virajgupta-pixel/emg-reaction-time-arduino/docs/BioE101_EMG_Reaction_Time_Final_Presentation.pdf

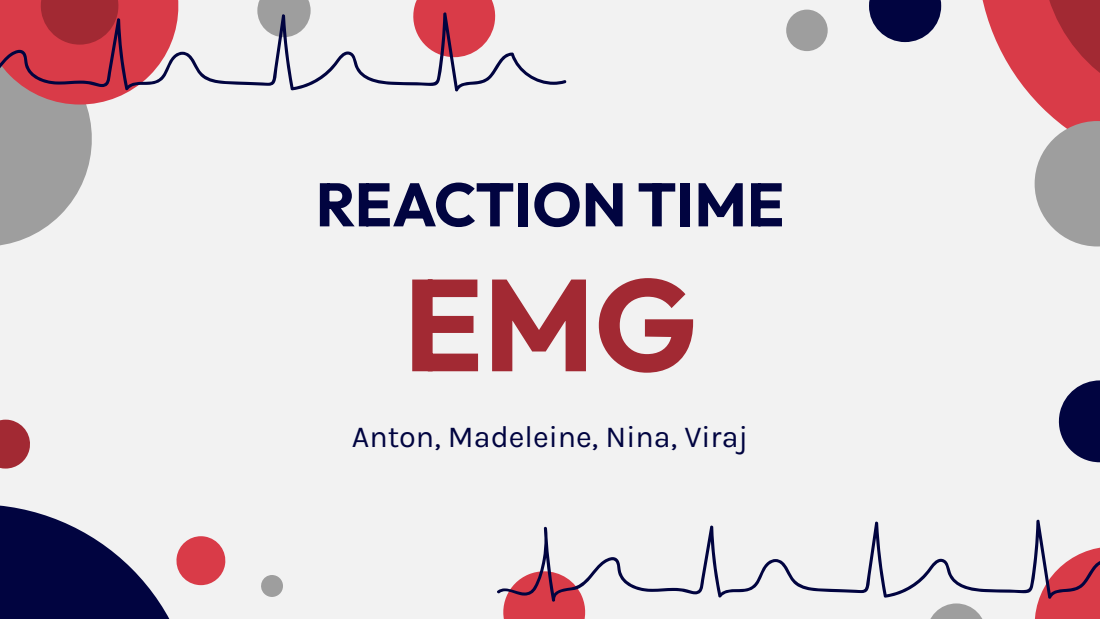
[picture p5: page 1]
REACTION TIME EMG

Anton, Madeleine, Nina, Viraj

10M+

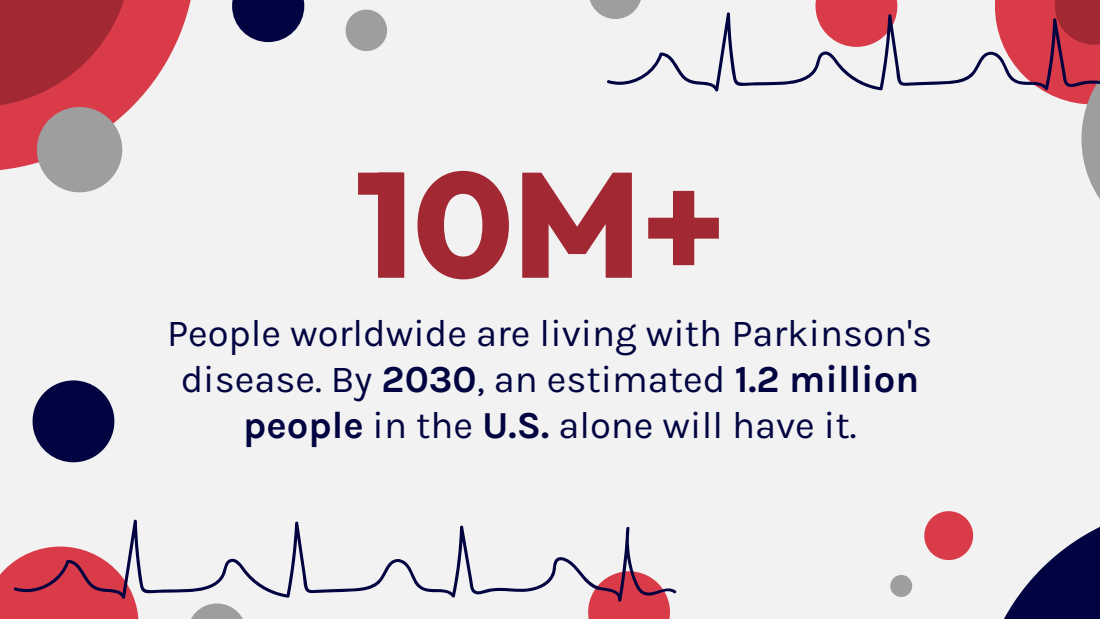
[picture p6: page 2]

People worldwide are living with Parkinson's
disease. By 2030, an estimated 1.2 million
people in the U.S. alone will have it.

# Why Measure Reaction Time?

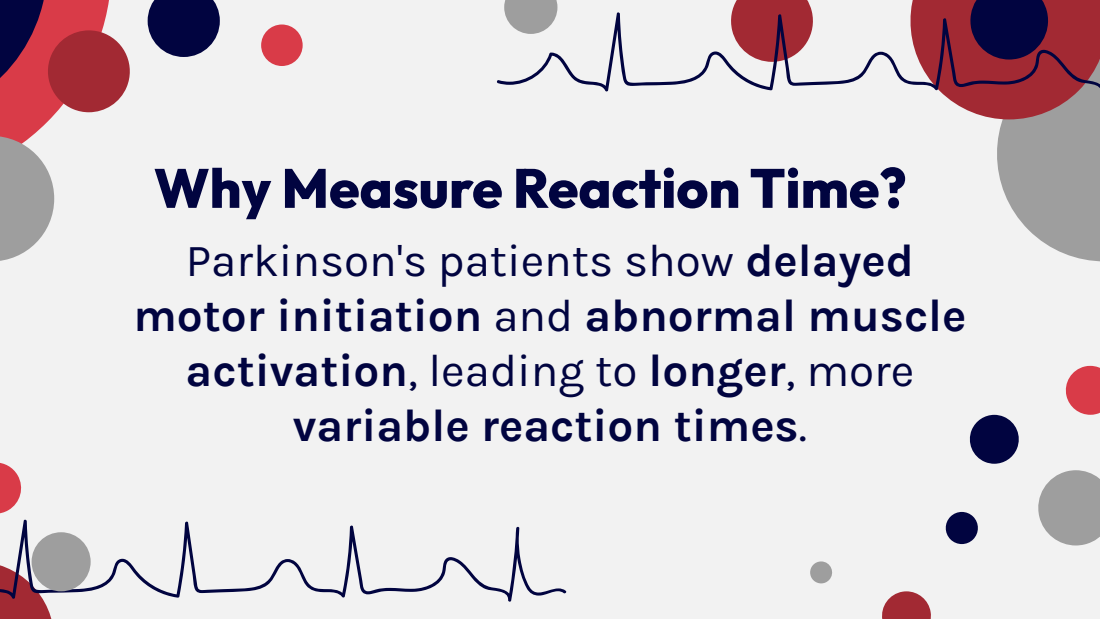
[picture p7: page 3]

Parkinson's patients show delayed
motor initiation and abnormal muscle
activation, leading to longer, more
variable reaction times.

# Compared Reaction Times

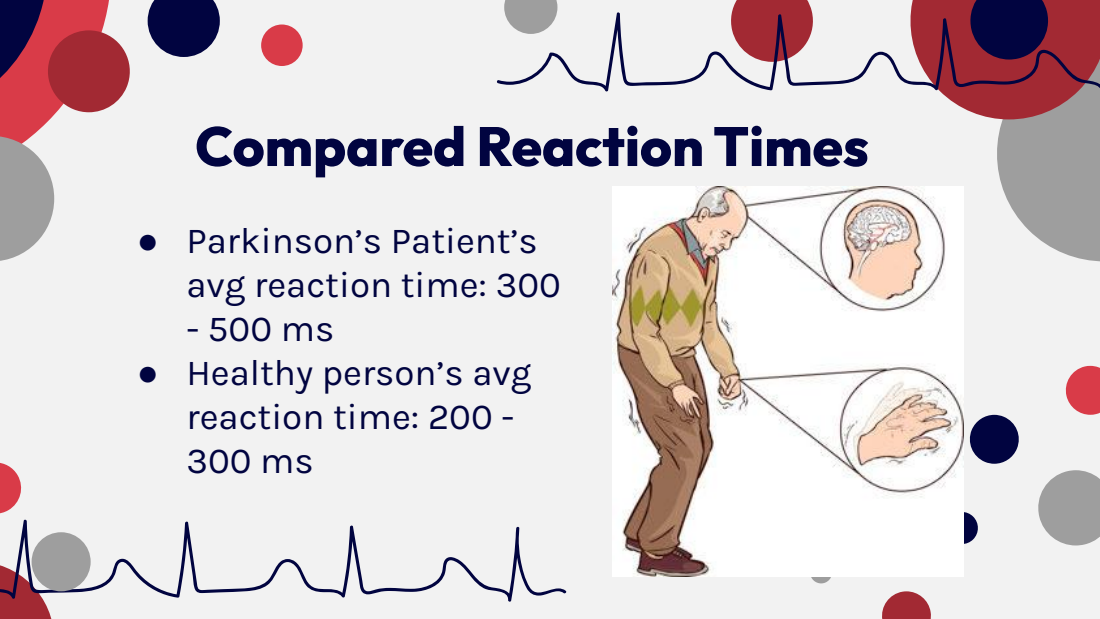
[picture p8: page 4]

● Parkinson’s Patient’s
avg reaction time: 300
● Healthy person’s avg
reaction time: 200 -

# Physiologic Requirements to Engineering Goals

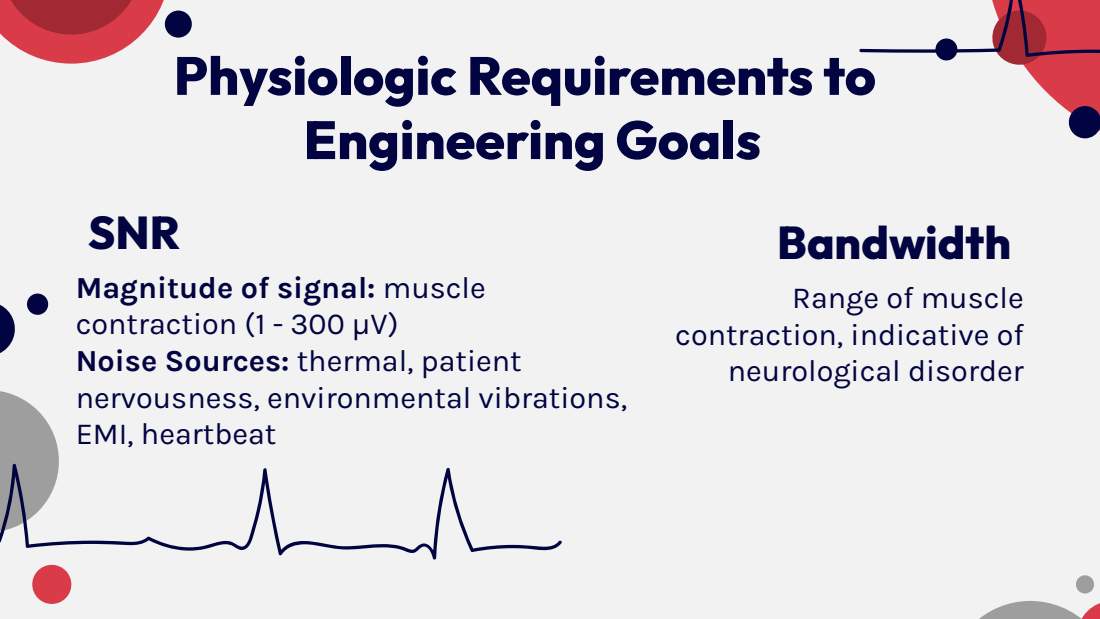
[picture p9: page 5]

SNR
Magnitude of signal: muscle
contraction (1 - 300 µV)
Noise Sources: thermal, patient
nervousness, environmental vibrations,
EMI, heartbeat

Bandwidth
Range of muscle

contraction, indicative of
neurological disorder

# Physiologic Requirements to

Engineering Goals Cont.

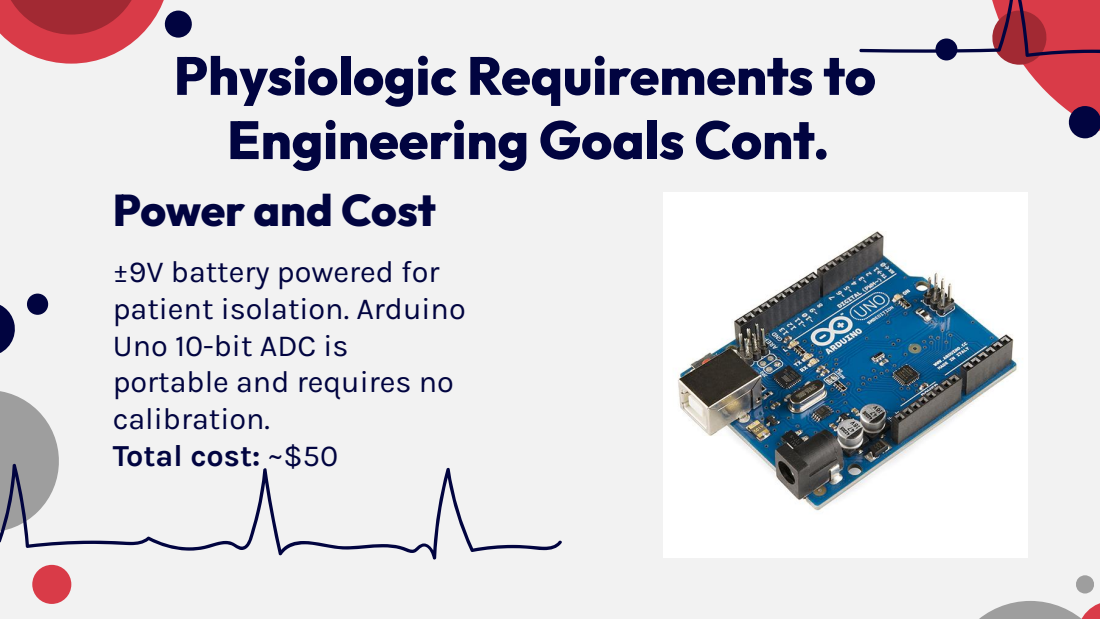
[picture p10: page 6]

Power and Cost

±9V battery powered for
patient isolation. Arduino
Uno 10-bit ADC is
portable and requires no
calibration.
Total cost: ~$50

## Measuring Reaction Time w/ EMGs

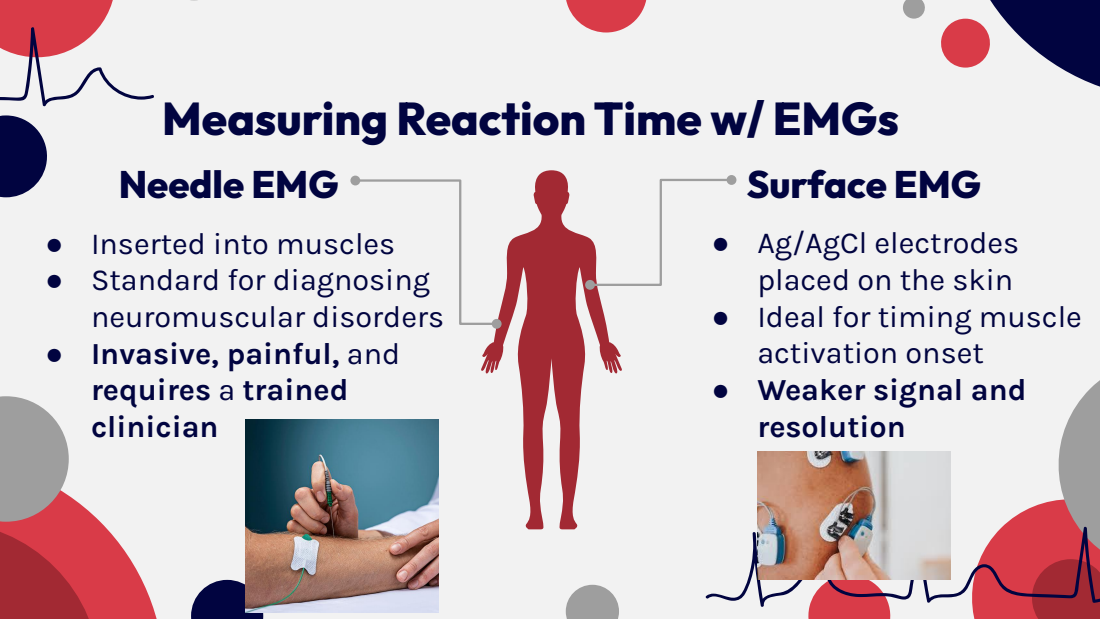
[picture p11: page 7]

Needle EMG
● Inserted into muscles
● Standard for diagnosing
neuromuscular disorders
● Invasive, painful, and
requires a trained
clinician

Surface EMG
● Ag/AgCl electrodes
placed on the skin
● Ideal for timing muscle
activation onset
● Weaker signal and
resolution

## EMG Circuit

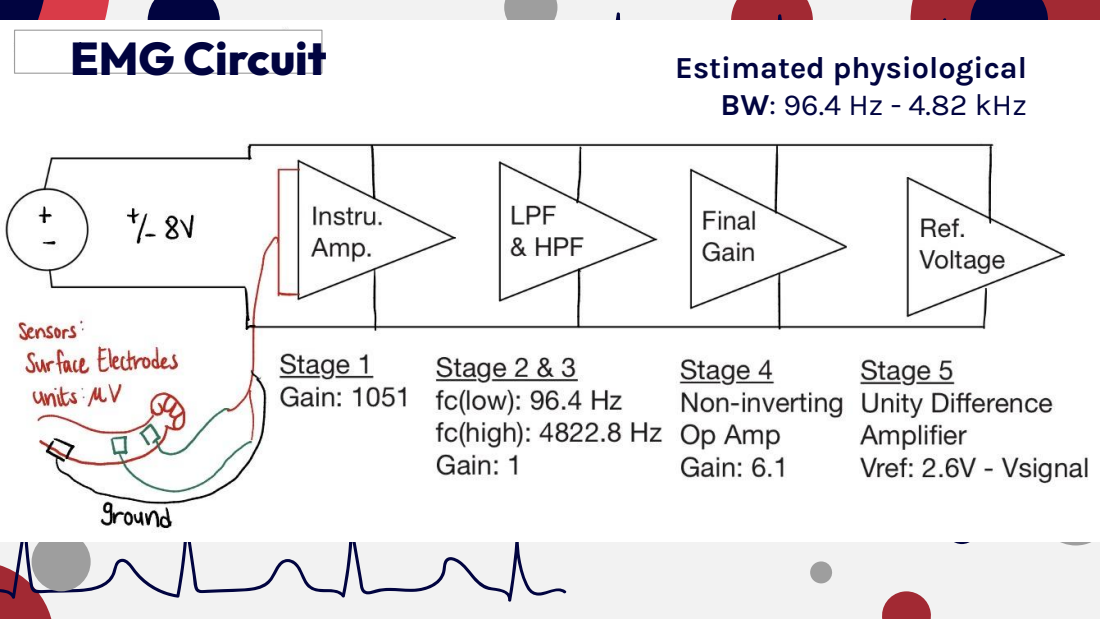
[picture p12: page 8]

Estimated physiological
BW: 96.4 Hz - 4.82 kHz

## Data Flow Circuit

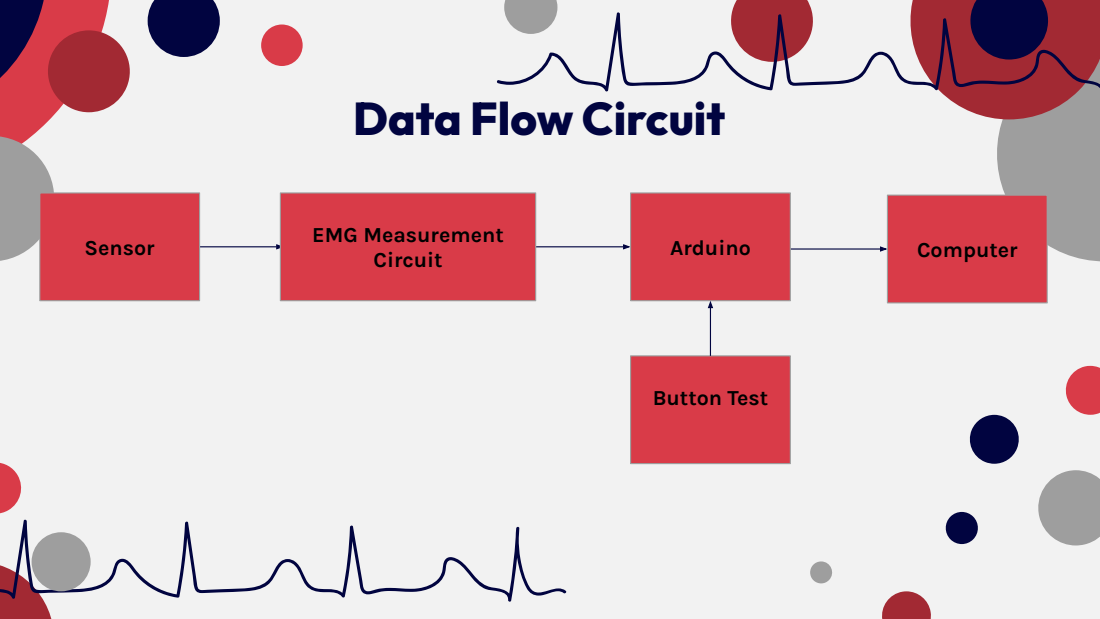
[picture p13: page 9]
Computer; EMG Measurement; Circuit; Arduino; Button Test; Sensor

# Signal, Noise & Interference Model

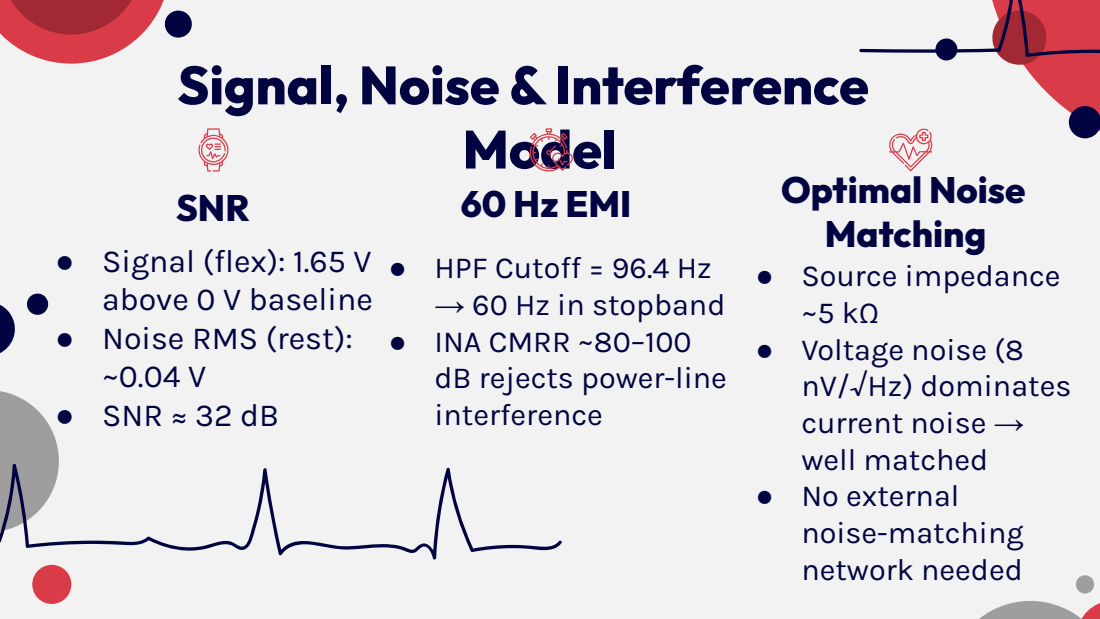
[picture p14: page 10]
60 Hz EMI; SNR

Optimal Noise
Matching
● Source impedance
● Voltage noise (8
nV/√Hz) dominates
current noise →
well matched
● No external
noise-matching
network needed

● Signal (flex): 1.65 V
above 0 V baseline
● Noise RMS (rest):
● SNR ≈ 32 dB

● HPF Cutoff = 96.4 Hz
→ 60 Hz in stopband
● INA CMRR ~80–100
dB rejects power-line
interference

# Anti-aliasing Filter & ADC

## AAF Design

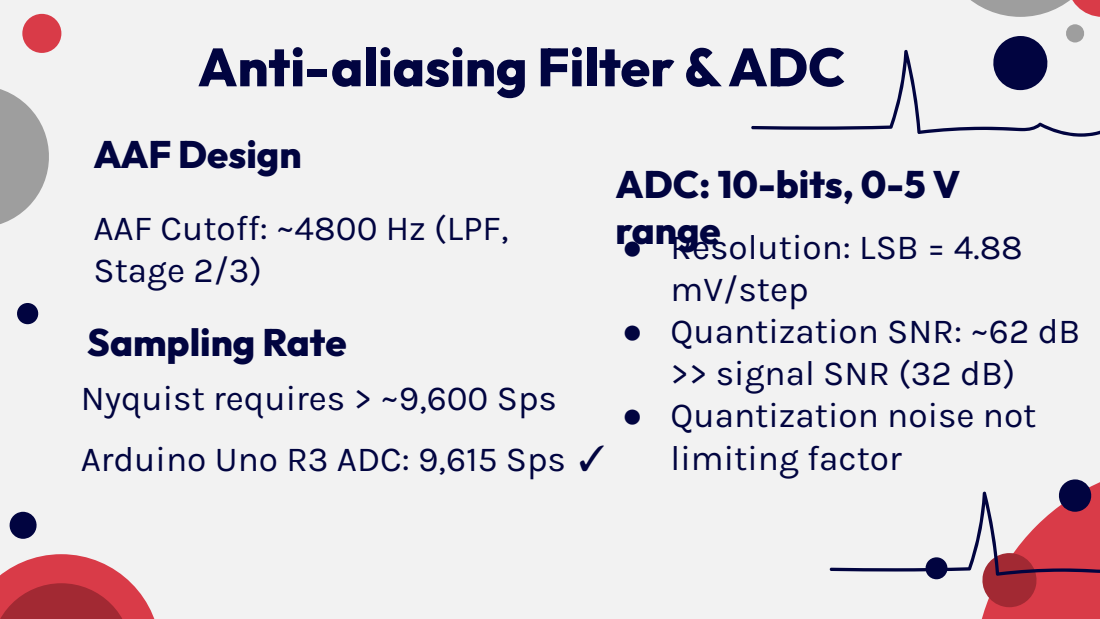
[picture p15: page 11]

ADC: 10-bits, 0-5 V
range ● Resolution: LSB = 4.88
mV/step
● Quantization SNR: ~62 dB
>> signal SNR (32 dB)
● Quantization noise not
limiting factor

AAF Cutoff: ~4800 Hz (LPF,
Stage 2/3)
Sampling Rate
Nyquist requires > ~9,600 Sps
Arduino Uno R3 ADC: 9,615 Sps ✓

# Measuring Reaction Time

## Button Pressing Test

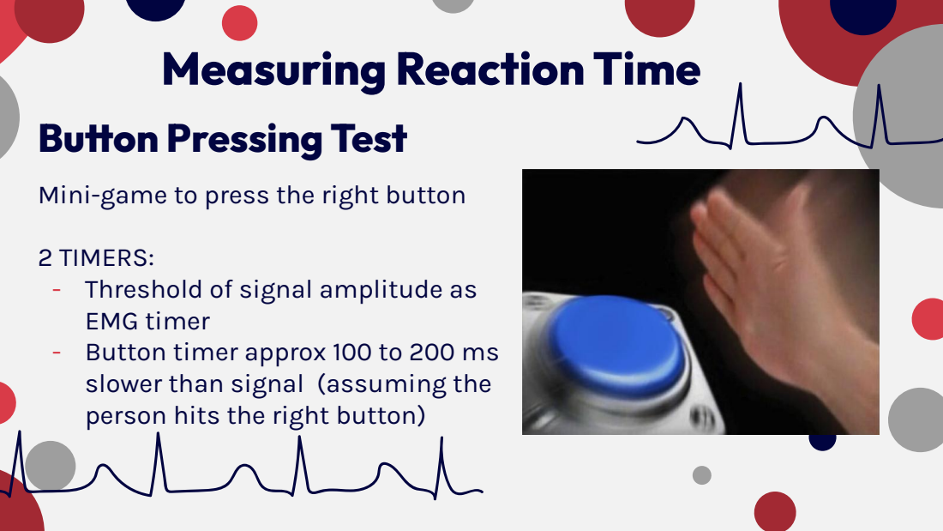
[picture p16: page 12]

Mini-game to press the right button

2 TIMERS:
- Threshold of signal amplitude as
EMG timer
- Button timer approx 100 to 200 ms
slower than signal (assuming the
person hits the right button)

## Physical Design + Demo

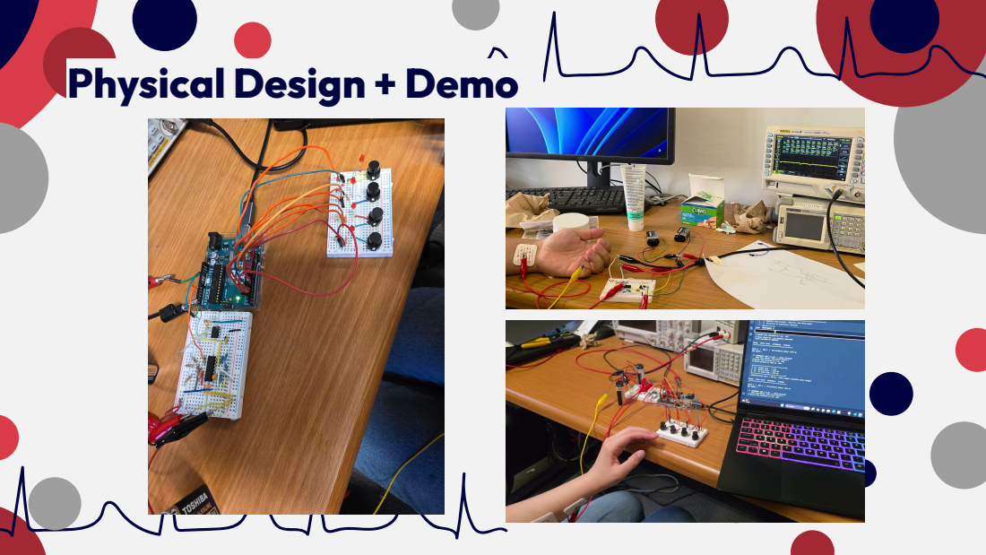
[picture p17: page 13]

# Prototype vs. Gold Standard

## Our Prototype

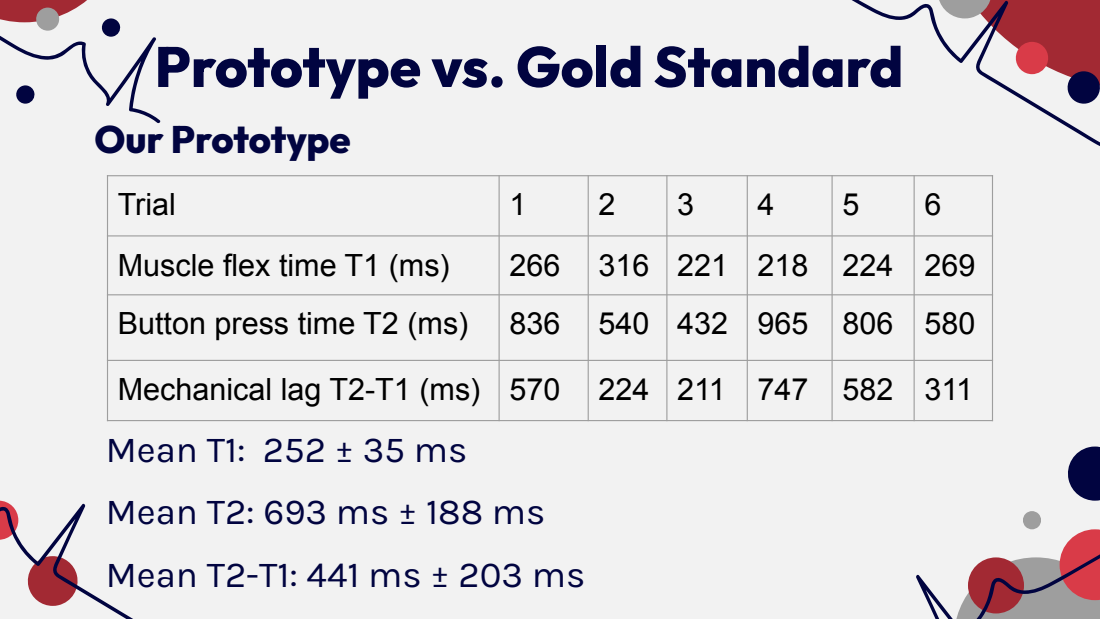
[picture p18: page 14]

Trial | 1 | 2 | 3 | 4 | 5 | 6

Muscle flex time T1 (ms) | 266 | 316 | 221 | 218 | 224 | 269

Button press time T2 (ms) | 836 | 540 | 432 | 965 | 806 | 580

Mechanical lag T2-T1 (ms) | 570 | 224 | 211 | 747 | 582 | 311

Mean T1: 252 ± 35 ms
Mean T2: 693 ms ± 188 ms
Mean T2-T1: 441 ms ± 203 ms

Prototype vs. Gold Standard Cont.

## Gold Standard

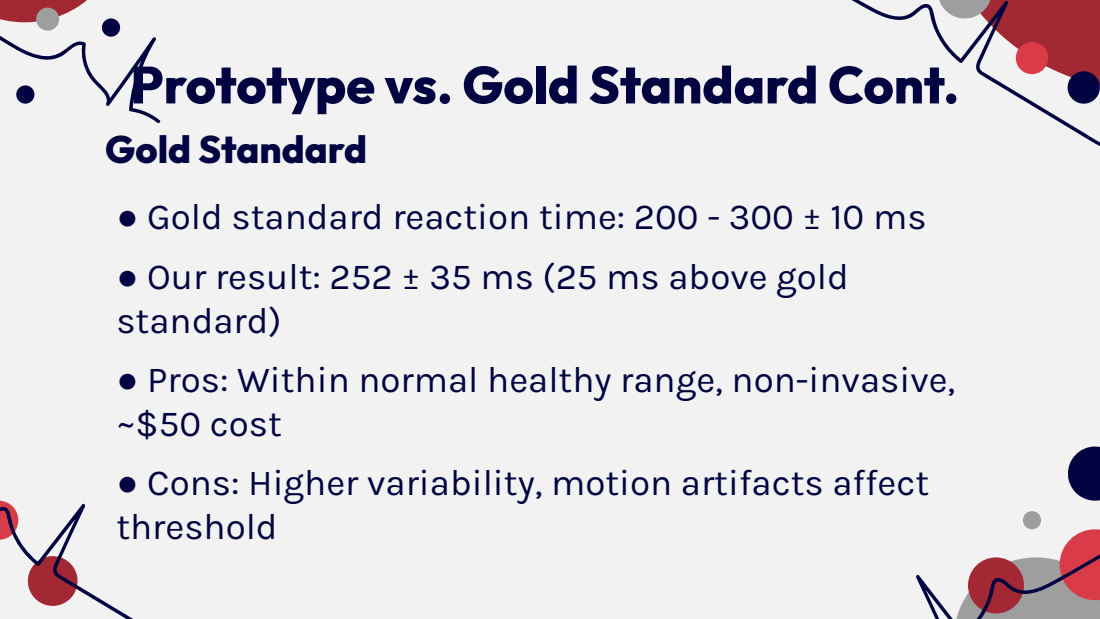
[picture p19: page 15]

● Gold standard reaction time: 200 - 300 ± 10 ms
● Our result: 252 ± 35 ms (25 ms above gold
standard)
● Pros: Within normal healthy range, non-invasive,
~$50 cost
● Cons: Higher variability, motion artifacts affect
threshold

# Tradeoffs & Lessons Learned

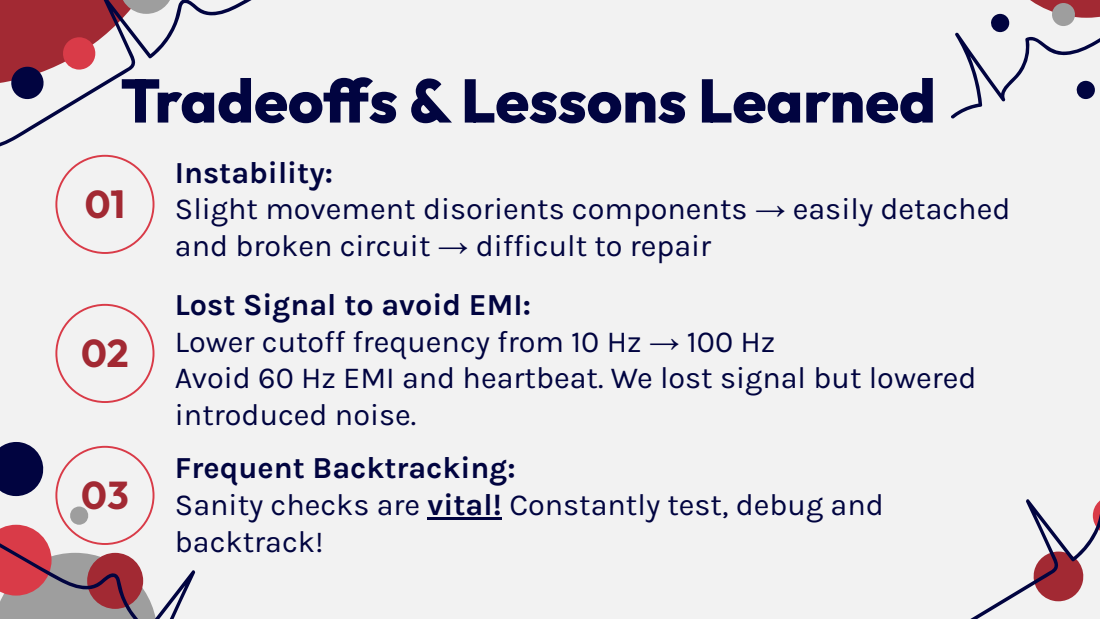
[picture p20: page 16]

Instability:
Slight movement disorients components → easily detached
and broken circuit → difficult to repair
Lost Signal to avoid EMI:
Lower cutoff frequency from 10 Hz → 100 Hz
Avoid 60 Hz EMI and heartbeat. We lost signal but lowered
introduced noise.
Frequent Backtracking:
Sanity checks are vital! Constantly test, debug and
backtrack!

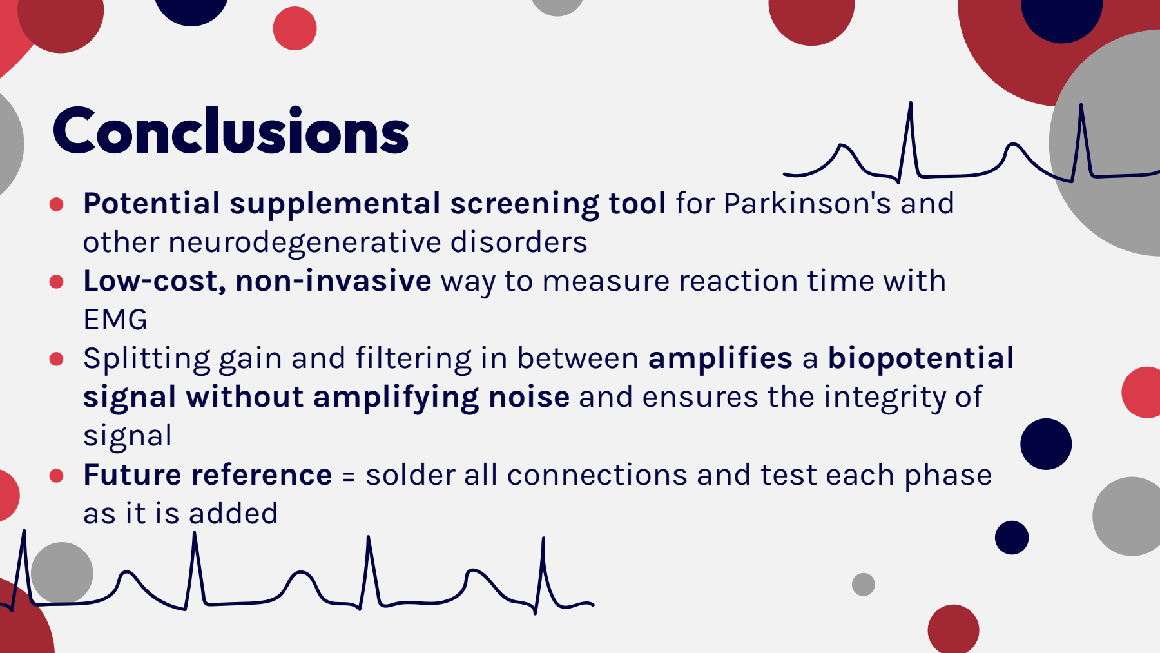
[picture p21: figure]
Conclusions; other neurodegenerative disorders; EMG; signal; as it is added

- Potential supplemental screening tool for Parkinson's and
- Low-cost, non-invasive way to measure reaction time with
- Splitting gain and filtering in between amplifies a biopotential signal without amplifying noise and ensures the integrity of
- Future reference = solder all connections and test each phase

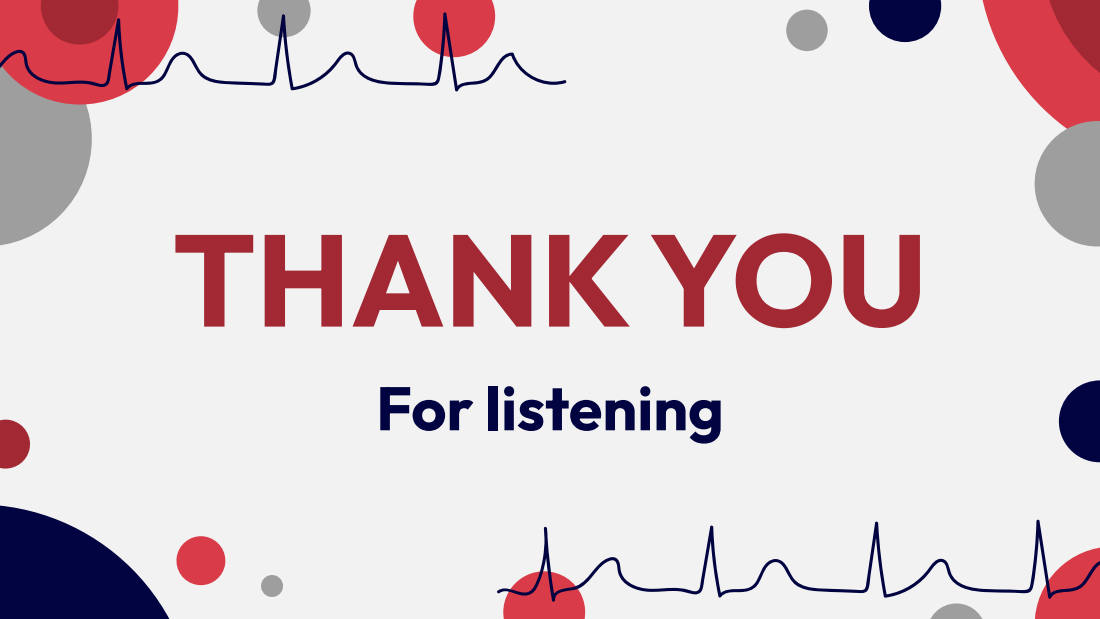
[picture p22: page 18]
THANK YOU; For listening

# References

https://www.parkinson.org/understanding-parkinsons/statisticshttps://pmc.ncbi.nlm.nih.gov/articles/PMC1032352/https://www.hopkinsmedicine.org/health/treatment-tests-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 omyography-emg (https://www.hopkinsmedicine.org/health/treatment-tests-and-therapies/electromyography-emg)
https://neuromedhub.com/basics-of-electromyography-emg-principles-technique-clinical-uses-and-interpretation/ (https://neuromedhub.com/basics-of-electromyography-emg-principles-technique-clinical-uses-and-interpretation/) https://my.clevelandclinic.org/health/diagnostics/4825-emg-electromyograph y (https://my.clevelandclinic.org/health/diagnostics/4825-emg-electromyography)
https://www.sciencedirect.com/science/article/pii/S1388245719308582https://journals.plos.org/plosone/article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

# References

Bloxham, C. A., Dick, D. J., & Moore, M. (1987). Reaction times and attention in Parkinson’s disease. Journal of Neurology, Neurosurgery & Psychiatry, 50(9), 1178–1183. https://doi.org/10.1136/jnnp.50.9.1178
Cleveland clinic. (2023, February 10). Electromyography (EMG). Cleveland Clinic. https://my.clevelandclinic.org/health/diagnostics/4825-emg-electromyography
John Hopkins Medicine. (2019). Electromyography (EMG). Johns Hopkins Medicine. https://www.hopkinsmedicine.org/health/treatment-tests-and-therapies/electromyography-emg Lakhani, B., Vette, A. H., Mansfield, A., Miyasike-daSilva, V., & McIlroy, W. E. (2012). Electrophysiological correlates of changes in reaction time based on stimulus intensity. PloS One, 7(5), e36407. https://doi.org/10.1371/journal.pone.0036407
NeuroMedhub. (2025, September 21). Electromyography Basics: Principles, Technique, Clinical Uses, and Interpretation. NeuroHub. https://neuromedhub.com/electromyography-basics-emg-principles-technique-clinical-uses-and-interpretation/
Parkinson's Foundation. (2025). Statistics. Parkinson’s Foundation. https://www.parkinson.org/Understanding-Parkinsons/Statistics
Stalberg, E. (2019). Standards for quantification of EMG and neurography. Clinical Neurophysiology, 130(9), 1688–1729. https://doi.org/10.1016/j.clinph.2019.05.008

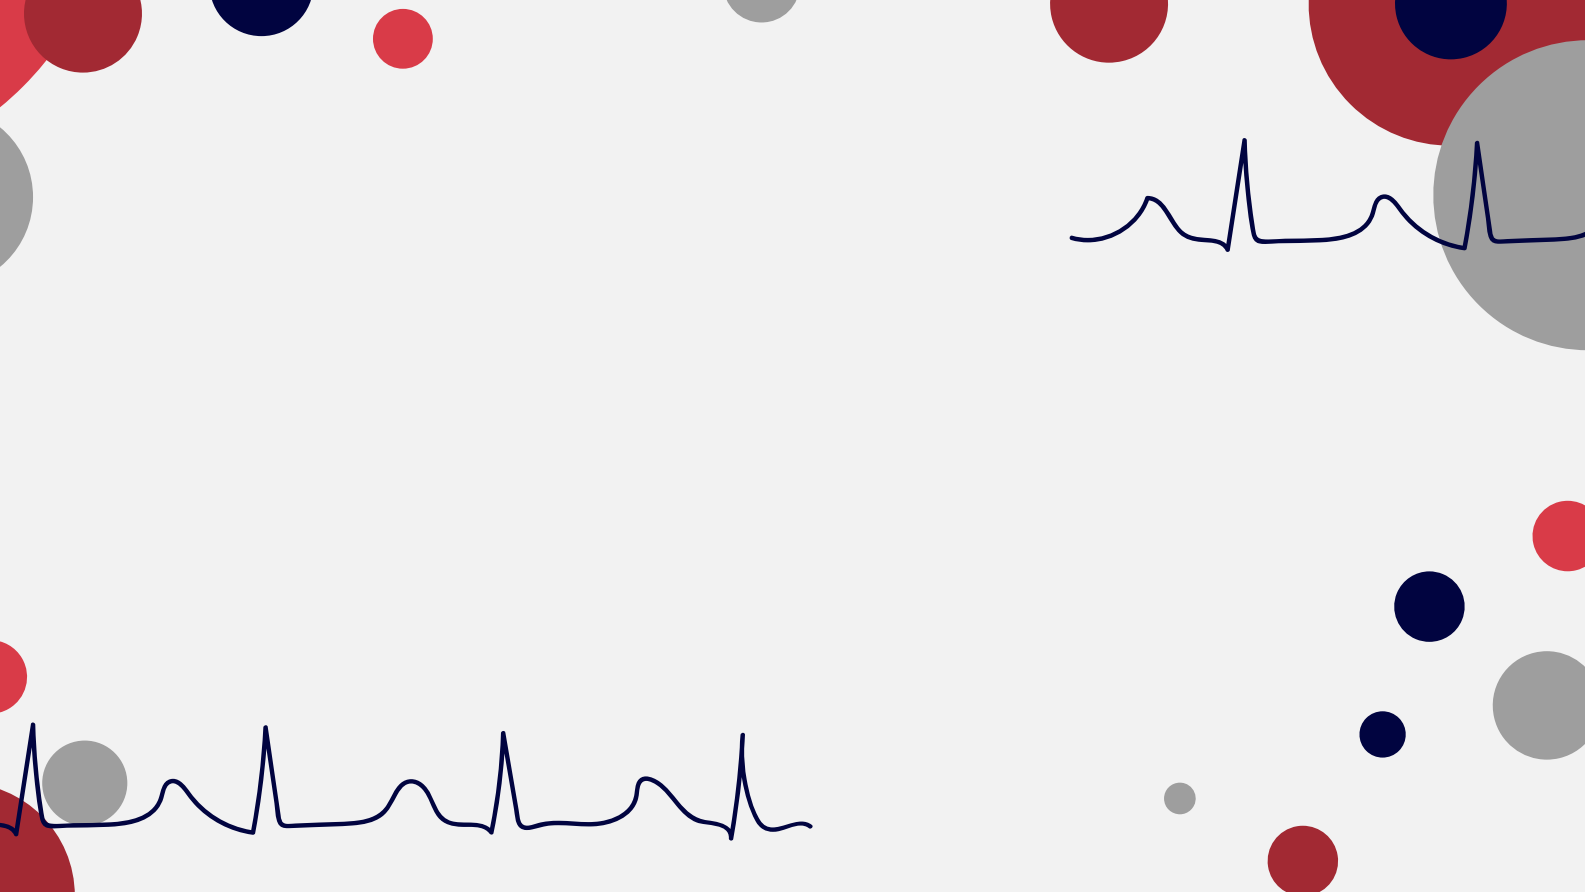
[picture p23: page 21]
